Mudycrafter-rubbish-coder/fpv/docs/img/README.md

# Documentation images

| File | Contents |
|---|---|
| `kepler-v-current.png` | Current Fusion assembly |
| `fc-vtx-wiring.png` | FC, VTX, camera, and auxiliary-board wiring |
| `z-stack.gif` | Original stack-height illustration |
| `fc-mount.png` | Flight-controller mounting detail |
| `screw-map.png` | Hardware map |
| `prop-compare.gif` | 3016-3 and 3020-3 comparison |

The earlier Fusion renders are in [`../previous-versions/images`](../previous-versions/images/).

The simulation figures are not stored here. Look in [`outputs/previous-versions`](../../outputs/previous-versions/).
