Mudycrafter-rubbish-coder/fpv/outputs/cad/README.md

# CAD files

## Current print set

All dimensions are in millimeters. The STL files are exported with the print face at `z = 0`.

| File | Size | Quantity | Notes |
|---|---|---:|---|
| [`v5-base-print.stl`](v5-base-print.stl) | 117.44 x 117.44 x 4.8 | 1 | Lower frame and VTX tray mounting points |
| [`v5-top-print.stl`](v5-top-print.stl) | 52 x 48 x 3.0 | 1 | Upper plate |
| [`v5-top-layer-spacer-4.5.stl`](v5-top-layer-spacer-4.5.stl) | 42 x 41 x 4.5 | 1 | Raises the upper plate and leaves room for camera uptilt |
| [`motor-spacer-3mm-four-hole-slot.stl`](motor-spacer-3mm-four-hole-slot.stl) | 18 x 18 x 3.0 | 4 | Four mounting holes and one side wire slot |
| [`v5-vtx-tray-separate.stl`](v5-vtx-tray-separate.stl) | 28.0 x 29.2 x 15.2 | 1 | Removable VTX and fan carrier |
| [`xt30-cable-clamp-base.stl`](xt30-cable-clamp-base.stl) | 20 x 12.5 x 5.2 | 1 | Fixed C body with two 3.9 mm hex nut pockets |
| [`xt30-cable-clamp-plate.stl`](xt30-cable-clamp-plate.stl) | 20 x 2 x 3.8 | 1 | Removable pressure plate |

The motor hole pattern is a 6.364 mm square with a 9.000 mm diagonal. The upper-plate support holes are at `x,y = +/-17.5 mm`. The camera holes in the lower frame are 20 mm apart.

## Archive

Older V2, V3, and V4 parts are in [`previous-versions`](previous-versions/).

Keep those files with the old revision notes. Several dimensions changed after those models were exported, including the motor pattern, camera spacing, VTX mount, and upper-plate height.
