Mudycrafter-rubbish-coder/fpv/assets/branding/README.md

# Kepler V 品牌资源

| 文件 | 说明 |
|---|---|
| `kepler-v-boot-logo.png` | Kepler V 开机 Logo 源图；288 × 72，绿色背景，用户提供 |

这是源资源，不是生成结果。需要飞控可用的 BMP 时，使用
`tools/osd_boot_logo.py` 转换到 `outputs/osd_logo/`，不要手工改 BMP 头。

当前输出：

- `outputs/osd_logo/kepler_v_boot_logo.bmp`
- `outputs/osd_logo/kepler_v_boot_logo_preview.png`

整机名称统一写 **Kepler V**。文件名中的 `v3` / `v3r` 属于 CAD 修订号，不是飞机名。
