Mudycrafter-rubbish-coder/fpv/docs/03-机架设计.md

# 03 · 机架设计

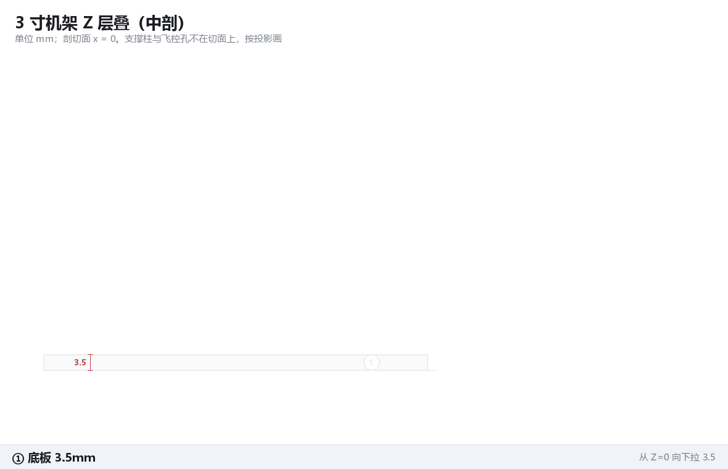
[picture p7: docs/img/z-stack.gif]
Z 层叠剖视


## 坐标系

**原点 = 机架中心，单位 mm，X = 左右，Y = 前后（+Y 朝机头），Z = 向上**

⚠️ 注意：**当前 Fusion 模型里底板占据 z = −4.0…0**。V5 增加 4.5 mm
`TOP_LAYER_SPACER` 后，上层板位于 z = 26.51…29.51；z = 0 仍是底板顶面。

> **2026-10 补充**：早期 DXF 底板厚 3.5 mm；当前做振动/冲击分析和准备打印的 STL 底板是 **4.0 mm**，上层板 3.0 mm。以 `outputs/cad/` 和 Fusion 里的实际模型为准。

## 尺寸表（v3）

| 项目 | 数值 |
|---|---|
| 电机中心 | (±47.73, ±47.73) |
| 轴距 | 135 mm |
| 相邻电机中心距 | 95.46 mm |
| 电机孔 | **孔心正方形，边长 6.364 mm，对角 9.000 mm**；4×M2 → Ø2.2 圆通孔（V5 定稿） |
| 电机座 | Ø20 圆盘 |
| 电机垫块 | **每电机 4 个独立圆小柱**（高 3 mm，**正方形孔心、9 mm 对角孔距**），整套相对机臂**顺时针 45°** |
| 中心板 | 八边形，对边 44 mm（±22），四角按 \|x\|+\|y\| = 40 切角 |
| 中心镂空 | **菱形，标称半对角 18 mm**（轴向理论宽度 36 mm，V5 扩大） |
| 机臂 | 宽 14 mm |
| 飞控孔 | **旋转 45°**：(±18.03, 0)、(0, ±18.03)，Ø2.2 |
| 支撑柱孔 | (±17.5, ±17.5)，Ø2.2（配 Ø6 柱，实购 4mm 六角黄铜也行） |
| 上下板净空 | **26.5 mm**（22 mm 支撑柱 + 4.5 mm spacer；上层板厚 3） |
| 上层板外廓 | 最大半宽 26 mm，y = −26…22 |
| 电池扎带槽 | 4 × 3.4×11 mm，位于 (±19, ±12) |
| GPS 卡槽 | 12.8 × 16.8 mm，深 2.0，R1.5，后侧 8 mm 出线缺口，中心 y=−32（V4 不装 GPS，改图传） |
| 相机扎带孔 | 4 × Ø2.6，位于 (±6.5, 22) 与 (±6.5, 30) |
| 相机托架 | V4 宽 24 mm，19 mm 双螺丝长条孔，最高 15.5 |
| 底板前端相机孔 | 两排 **x=±10.0 mm**（左右中心距 **20 mm**），y=22 / 30 |
| 独立 VTX 托架 | 28.0 × 29.2 × 13.9 mm；上下框 + 4 立柱，四颗 M2 固定 |
| 板厚 | 底板 **4.0**，上层板 3.0（早期 DXF 底板 3.5） |

## 螺丝长度怎么来的

规则：**长度 = 穿过的板厚 + 2.5mm 咬合**。完整分配表见 [01-零件规格](01-零件规格.md) 的"五金"一节，
孔位对应见下面的 `screw-map`。

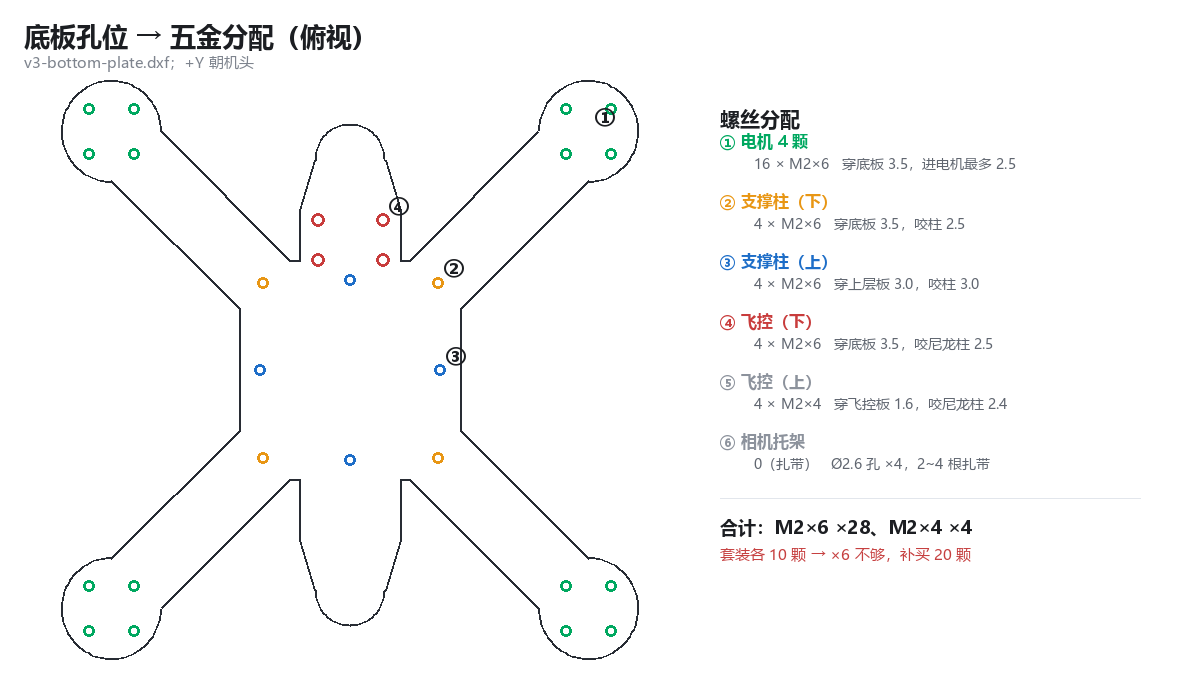
[picture p8: docs/img/screw-map.png]
底板孔位与五金分配


关键几条：

- **V4 电机用 M2×10 + 0.5 平垫**：底板 4.0 + 垫块 3.0 + 进电机 2.5；没有垫块时不要用 M2×10
- **支撑柱两端各 4 颗 M2×6**：下 4.0+2.0、上 3.0+3.0
- **飞控**：下面 4 颗 M2×6 拧进 5mm 尼龙母母柱，上面 4 颗 M2×4 穿过飞控板压住

## 两处关键的间隙校核

**桨盘余量**：底板与上层板的外沿距离任何电机中心都 **≥ 40.10 mm**，而桨的扫掠半径是 38.1 mm → 留 2 mm。
（脚本每次生成都会自动校验，改动外形后如果这个数掉到 38.1 以下会报警。）

**相机间隙**：相机托架斜面最高处 z=8.66，S1039 当前 22° 静态包络最高处约
z=20.49；增加 4.5 mm spacer 后，上层板底面在 z=26.51，静态余量约 **6.0 mm**，
为 uptilt 留出更多空间。

## 图纸状态与待确认项

> **2026-10-19 更新**：Fusion 整机装配已改用修订版托架
> `outputs/cad/previous-versions/v3/v3r-camera-tray.stl`（去掉挡镜头的前唇、加侧颊和飞控尼龙柱避让口）。
> 旧 `v3-camera-tray.stl` 只作历史对照，**不要再用它打印**。详见
> [11 · Fusion 整机装配模型](11-Fusion整机装配模型.md)。

1. **相机托架已解决**：旧 `outputs/cad/previous-versions/v3/v3-camera-tray.stl` 有挡镜头前唇和 Z 偏置问题，
   只保留作历史对照。后续版本使用 `outputs/cad/previous-versions/v3/v3r-camera-tray.stl`：已按打印坐标导出，
   底面 `z=0`，水密，并避开 S1039 镜头和飞控前侧尼龙柱。详见
   [11 · Fusion 整机装配模型](11-Fusion整机装配模型.md)。
2. **上层板也有一组飞控孔**（Ø2.2 ×4），但飞控是装在底板上的，这 4 个孔目前没有用途 ——
   要么留着当"飞控吊装在上层板下"的备选方案，要么删掉，别两边都留着又都不知道为什么。

## 版本演进

| 版本 | 内容 | 文件 |
|---|---|---|
| v1 | 单层底板，纯 2D 概念 | `outputs/cad/archive/3in-frame-1to1.dxf` / `.svg` / `-preview.png` |
| v2 | 双层结构、长中舱、机鼻机尾、相机托架 | `outputs/cad/archive/v2-bottom-plate.dxf`、`v2-top-plate.dxf`、`v2-camera-tray.dxf` / `.stl` |
| **v3** | **34→44 中心板、飞控转 45°、GPS 卡槽、托架前移 8 mm；历史基线** | `outputs/cad/previous-versions/v3/` |

v2 已作废的原因：飞控改成 45° 摆放后，安装孔落在坐标轴上，原中心板（±17）没有材料承载，必须扩到八边形 ±22。

## 图纸与图层

最新图纸在 `outputs/cad/`：

- `v3-bottom-plate.dxf` — 旧底板
- `v3-top-plate.dxf` — 旧上层板
- `v4-camera-tray.stl` — 当前相机托架（24 mm 宽，19 mm 双螺丝长条孔）
- `v3-camera-tray.stl` — 旧相机托架（前唇挡镜头，只作历史对照）
- `v3-preview.png` — 俯视预览（含前方箭头）

**要切的图层：**

| 图层 | 内容 |
|---|---|
| `CUT` | 外形 |
| `MOTOR_M2_9x9` | 16 个 Ø2.2 电机孔 |
| `FC_M2_25.5_ROT45` | 4 个 Ø2.2 飞控孔 |
| `STANDOFF_M2` | 4 个 Ø2.2 支撑柱孔 |
| `CAM_TIE` | 4 个 Ø2.6 扎带孔 |
| `GPS_POCKET` | GPS 卡槽轮廓 + 出线缺口 |
| `POCKET_OPT_1.5DEEP` | 可选：飞控底部元件避让凹槽（45° 菱形，深 1.5）——用 5mm 尼龙柱垫高后**可以不用切** |
| `BAT_STRAP` | 电池扎带槽（仅上层板） |

**只看不切（拉伸前删掉）：** `REF_PROP_3IN`（桨盘 Ø76.2）、`REF_MOTOR_CENTER`、`REF_BOARD_30_ROT45`（飞控板菱形轮廓）。

## Fusion 里的装配步骤

1. 导入 DXF（单位 mm、比例 1），草图落在 XY 平面、原点对齐
2. 底板：从 Z=0 **向下**拉 4.0 mm（对应模型的 −4.0…0）
3. 上层板：草图抬到 **Z=22**，向上拉 3 mm
4. 相机托架：旧版见 `previous-versions/v4/v4-camera-tray.stl`
5. 支撑柱：4 根 Ø6×22（实购 22mm），中心 (±17.5, ±17.5)

**自检**：导入后量三个数 —— 相邻电机孔中心距 **95.46**、飞控四孔 **25.5×25.5**、中心板 **44×44**（对边）。对得上说明没被缩放。

## 打印要求

**早期打印基线来自 [07 · 振动与打印材料方案](previous-versions/07-振动与打印材料方案.md)：PLA 4.0 mm 机臂。**
PLA 脆、耐热差，但现有厚度、螺丝长度、整机模态和冲击分析都是按它校核的；如果改用 PETG，
不要只替换材料，必须按实际厚度重新核对电机螺丝进入量、支撑柱和整机模态。

**必须平躺打印。** 让机臂的抗弯落在 XY 平面内 —— 竖着打的话一撞就从层间劈开，这是打印机架最常见的死法。

**填充**：5 圈壁、5–6 层顶/底实心层、60–80% gyroid；**机臂根部和电机座周围单独拉到 100%**。

**螺丝孔**：PLA 不要自攻（拆两次就滑牙），走 Ø2.2 通孔 + M2 螺母/铜柱。沉台不要再挖了 —— 挖薄后只允许 M2×4，反而更麻烦。

**"防炸"的本质是牺牲式连接**：撞机时让电机先被撕掉，而不是把底板撕开。所以电机座边距留到 2 mm 以上（PAD_R=10 而不是 9），相机和 GPS 全部软固定。

## 生成脚本

`work/` 下的脚本，所有尺寸都在文件开头，改完重跑即可：

| 脚本 | 作用 |
|---|---|
| `make_frame_v3.py` | 底板 + 上层板 + 预览图；`FC_ROT_45` 一行切换飞控朝向 |
| `make_tray.py` | 相机托架 STL |
| `check_frame.py` | DXF 结构审计 + 轮廓闭合性校验 |
| `inspect_dxf.py` | 列出 DXF 里所有实体（核对别人的图很有用） |
| `make_doc_assets.py` | 生成文档用的示意图和 GIF（`docs/img/`） |

运行环境：项目根目录的 `.venv`（含 ezdxf / trimesh / shapely / pillow）。
