Mudycrafter-rubbish-coder/fpv/docs/05-采购与预算.md

# 05 · 采购与预算

> **状态：已采购（2026-10）。** 下面第一份是最终实配清单，第二份是当初按"能不能飞"分批的预算方案
> （留着看省钱思路，价格是 2026-09 的估算）。
> 表格按最终方案整理，**具体品牌和数量以订单为准**。

## 一、最终实配清单

| 类别 | 项目 | 规格要点 | 数量 |
|---|---|---|---|
| 遥控 | ELRS 遥控器 | 2.4G，与板载 ELRS 匹配 | 1 |
| 动力 | 电机 | **1106 4200KV** | 4 |
| | 桨（主力） | Gemfan **3020-3**，**1.5mm 中心孔** | 8 |
| | 桨（长续航） | Gemfan **3016-3**，**1.5mm 中心孔** | 4 |
| | 电池 | 3S 650mAh ≥45C（基准）／ 3S 850mAh 70C（长续航） | 各 1 |
| | 充电器 | B3（已有）+ 电压表 + 防爆袋 | — |
| 控制 | 飞控 | JHEMCU GHF435AIO V2 | 1 |
| 视频 | 图传 | EWRF TS5823 Pro 600mW | 1 |
| | 摄像头 | S1039 1200TVL | 1 |
| | 眼镜 | DMKR 008D Pro | 1 |
| 导航 | GPS | UPRiiGNSS PU-122Q | 1 |
| 五金 | 见下表 | | — |
| | 蜂鸣器 | 5V 有源 | 1 |

### 五金明细

| 项目 | 规格 | 数量 | 说明 |
|---|---|---|---|
| M2 螺丝套装 | ×4 / ×6 / ×8 / ×10 / ×12 / ×14 / ×16 / ×18 / ×20 **各 10 颗** + M2 螺母 ×20 | 1 套 | 便宜且够用，剩下的留给以后改装 |
| M2×6 补货 | M2×6 | **+20 颗** | 整机要 28 颗，套装只给 10 颗 |
| 支撑柱 | **M2 母母 22mm**（黄铜 4mm 六角 / Ø6 都行） | 4 | 22mm 净空由它决定，**不是 25mm** |
| 尼龙柱 | M2 母母 **5mm** | 4 | 飞控垫高，避开板底元件 |
| 平垫 | Ø2.2 ×0.3~0.5 | 若干 | 电机那 16 颗用来压进入量 |
| 接头 | XT30 公母 | 1~2 对 | 做飞控电池引出线；B3 走平衡头，不需要 |
| 电容 | 470µF 低阻（≥220µF） | 1（+1 备用） | 并电池焊盘 |
| 线材 | **18AWG** 硅胶线 | 红黑各 ~0.5m | 满油 34A，20AWG 太细 |
| 其他 | 热缩管、2.5mm 扎带、**电池扎带（10mm 魔术贴）**、**RP-SMA 弯头/延长线** | | 后两样是旧清单漏的 |
| 保护件 | SS14 肖特基 ×2、2N7002 ×2、1kΩ 电阻 ×2 | | 防反接 + 录像模块触发 |

### 螺丝都拧在哪

底板孔位与五金分配

| 位置 | 长度 | 数量 |
|---|---|---|
| 4 个电机 | M2×6 | 16 |
| 支撑柱 ↔ 底板 | M2×6 | 4 |
| 支撑柱 ↔ 上层板 | M2×6 | 4 |
| 飞控 ↔ 尼龙柱（下） | M2×6 | 4 |
| 飞控 ↔ 尼龙柱（上） | M2×4 | 4 |
| 相机托架 | 扎带 | 0 螺丝 |
| **合计** | **M2×6 ×28、M2×4 ×4** | 32 |

装配层次和相机/电池/净空的关系：

Z 层叠剖视

## 二、分批预算方案（2026-09 存档）

预算 ¥1200，当时按"能不能飞"排序买了三批。实际下单时五金按上表改了，价格也随行情浮动。

| 批次 | 内容 | 估价 |
|---|---|---|
| 第一批"能飞起来" | 遥控（二手）+ 飞控 + 电机 + 图传 + 摄像头 + 桨 + 电池 + 手机接收棒 ROTG01 + 充电 + 五金 | ≈¥1115 |
| 第二批"能看到画面" | 眼镜 DMKR 008D Pro + GPS + 第二块电池 | ≈¥380 |
| 第三批"省心的" | 备用桨 + SS14 + 2N7002 + 备用天线 + TPU/泡棉 | ≈¥85 |

### 省钱的三条路

**用手机当屏幕**：EWRF ROTG01 那种 USB OTG 的 5.8G 接收棒约 ¥80，插手机上看画面，替掉眼镜。
缺点是屏幕在手上，飞行体验不如眼镜，但起步完全够。

**遥控器买二手**：ELRS 遥控器二手很常见，这东西不像电机，摔不坏。

**先目视飞**：第一批只买"能飞"的最小集，先不带图传飞。听起来像退步，其实一开始目视飞最好：
能听电机声音判断震动、能直接看姿态、调好 PID 再上图传，摔了也知道怎么摔的。

## 买东西时容易买错的五样

| 项目 | 坑 |
|---|---|
| 桨 | **3020-3 / 3016-3 都有 1.5mm 和 2mm 两种中心孔**，电机是 1.5mm 轴 |
| 电机螺丝 | 只能用 **M2×6**：M2×4 咬 0.5mm 会滑牙，M2×7 顶到线圈烧电调 |
| 支撑柱长度 | 是 **22mm**，不是 25mm（25 会把上层板顶高 3mm，图纸全对不上） |
| 电池 | 看放电倍率不看容量：45C 450mAh 只有 20A，不够；而且 XT30 连续只到 ~30A |
| B3 充电器 | 有 220V 直插版和 12V 输入版，买错还得配电源 |

## 拆机电机验货清单

1. 手拨一下，听有没有沙沙的轴承声
2. 捏住轴承位置轴向/径向晃，**有旷量直接放弃**
3. 看线材绝缘有没有破皮、焊点有没有发黑过热
4. 万用表量三相电阻，三个值应基本一致
5. 铁螺丝靠近定子，四颗吸力应相近（弱的那颗可能退过磁）
6. **四颗必须同型号同 KV**
