Mudycrafter-rubbish-coder/fpv/outputs/previous-versions/README.md

# Previous outputs

This directory holds files from earlier revisions.

| Folder | Contents |
|---|---|
| [`v2/`](../cad/previous-versions/v2/) | Earliest 3-inch frame and camera-tray files |
| [`v3/`](../cad/previous-versions/v3/) | V3 frame drawings, old camera trays, and antenna mount |
| [`v4/`](../cad/previous-versions/v4/) | V4 measured-fit parts |
| [`vibration/`](vibration/) | Arm vibration and material study |
| [`assembly/`](assembly/) | Full-assembly modal results |
| [`impact/`](impact/) | Screw pullout, arm impact, and slot tests |
| [`sim-v1-manual/`](sim-v1-manual/) | First manual simulation pass |

These files are useful for understanding how the design changed. Use the current STL set in [`../cad`](../cad/) for a new build.
