Mudycrafter-rubbish-coder/fpv/docs/img/prop-compare.png

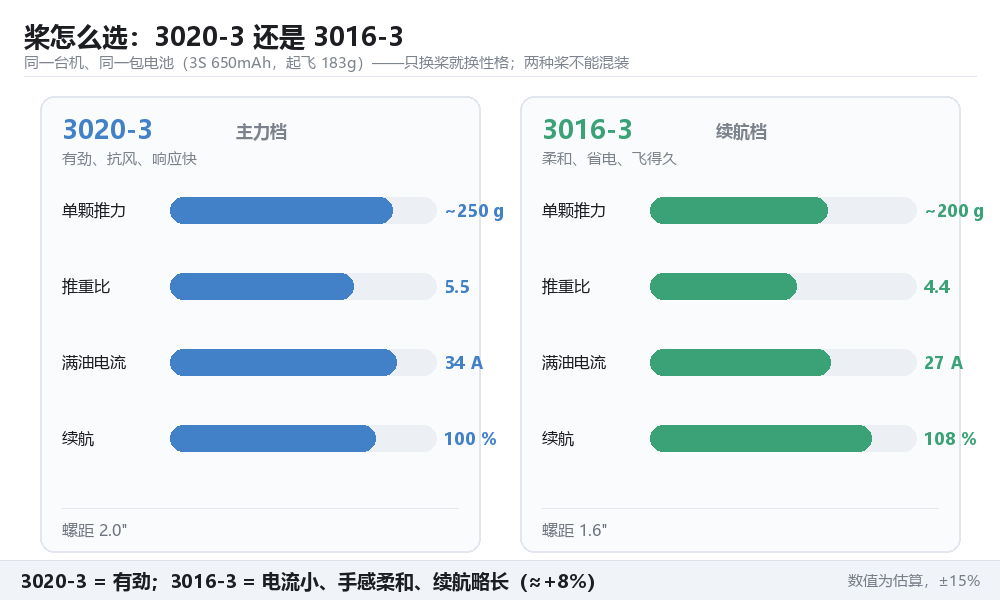
docs/img/prop-compare.png
