Mudycrafter-rubbish-coder/fpv/docs/img/z-stack.png

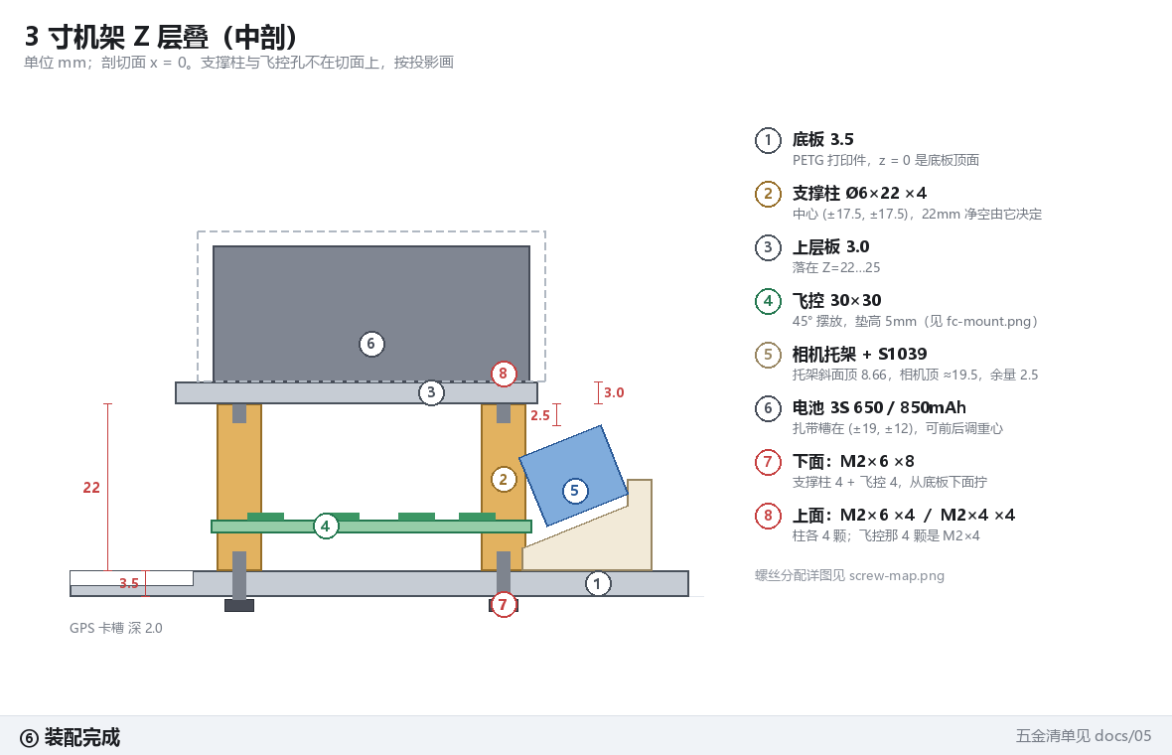
docs/img/z-stack.png
