Mudycrafter-rubbish-coder/fpv/outputs/cad/v3-preview.png

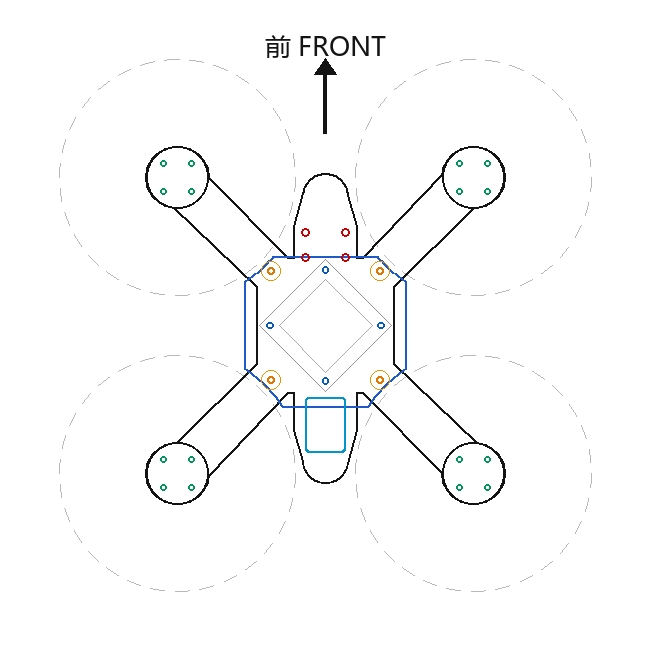
outputs/cad/v3-preview.png
