Mudycrafter-rubbish-coder/fpv/outputs/impact/stack_hole/pull_100N_stress_map.png

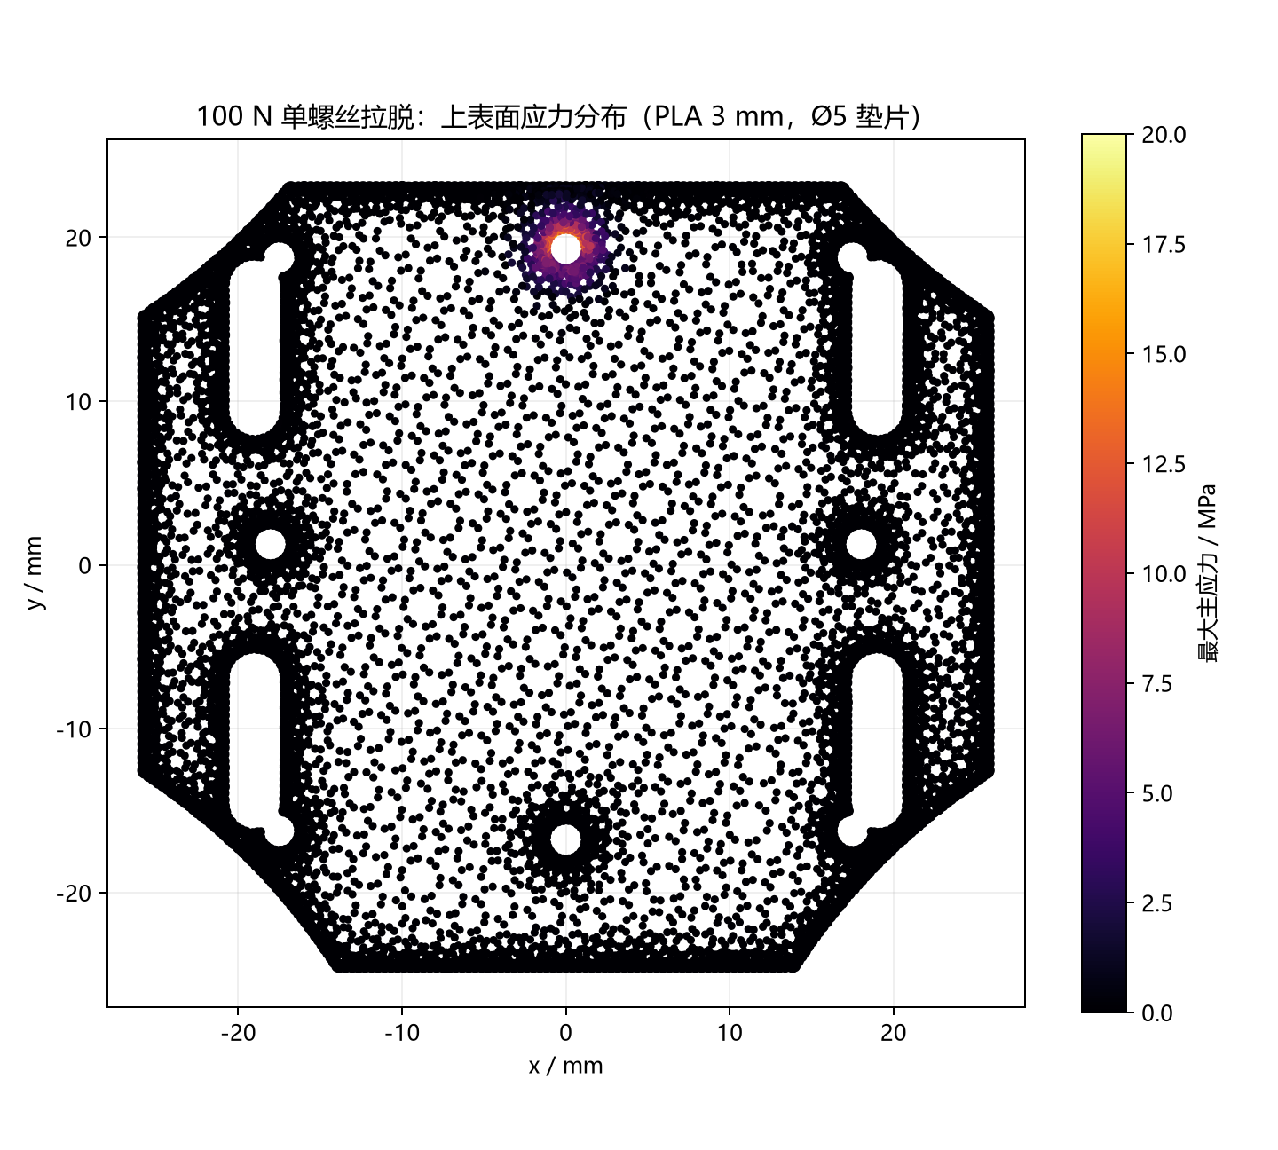
outputs/impact/stack_hole/pull_100N_stress_map.png
