Mudycrafter-rubbish-coder/fpv/outputs/osd_font/blank_11x17.png

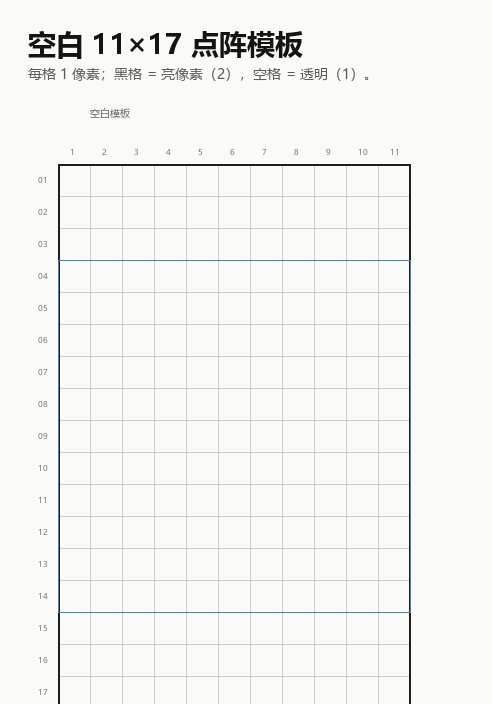
outputs/osd_font/blank_11x17.png
