Mudycrafter-rubbish-coder/fpv/outputs/osd_font/dotmatrix_page_02.png

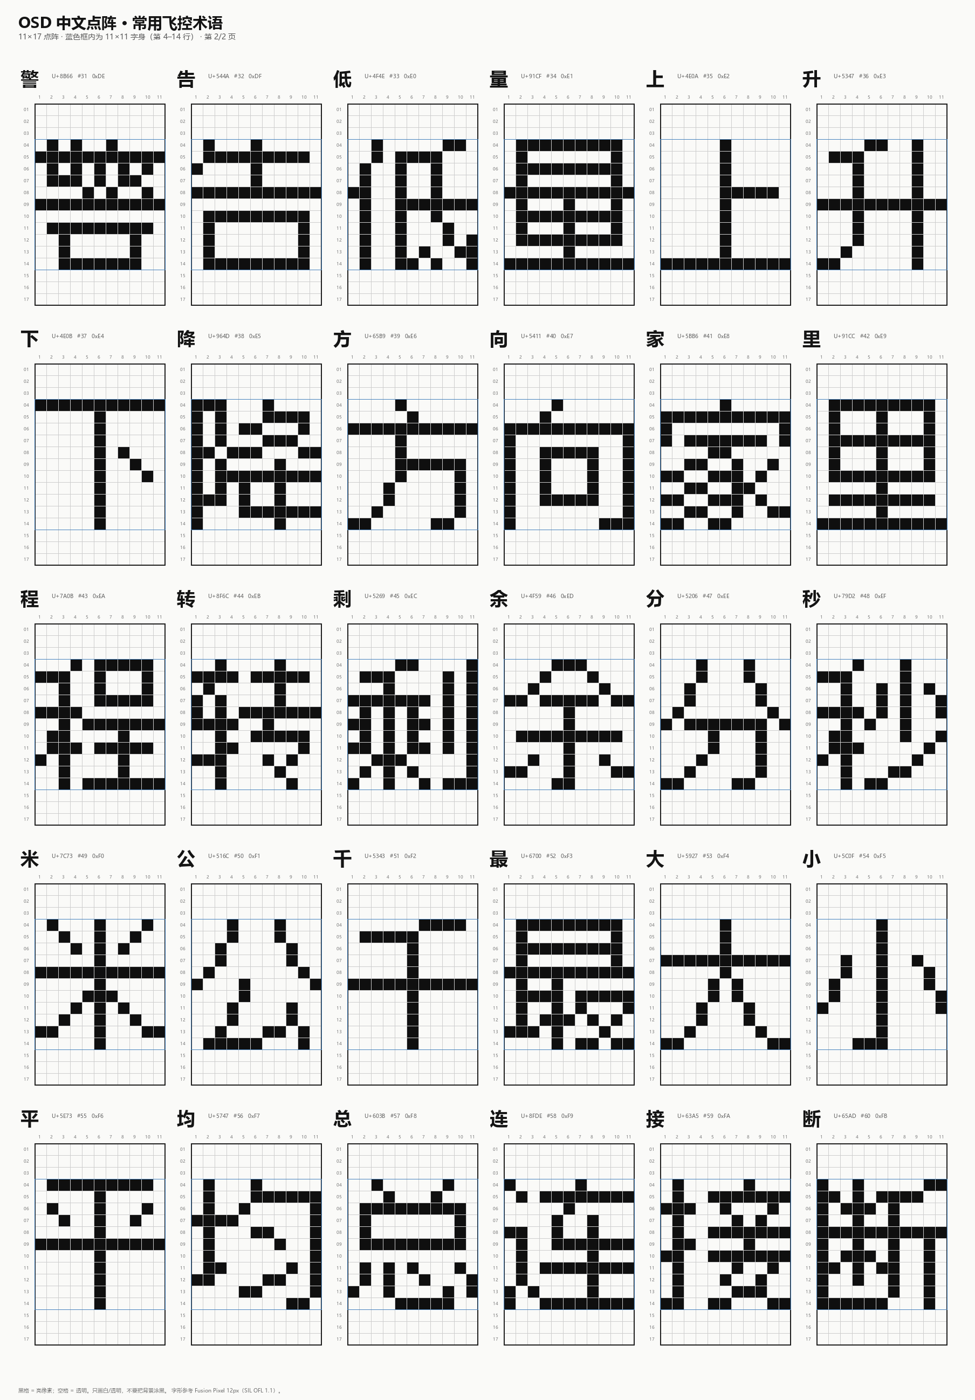
outputs/osd_font/dotmatrix_page_02.png
