Mudycrafter-rubbish-coder/fpv/outputs/osd_font/preview_osd.png

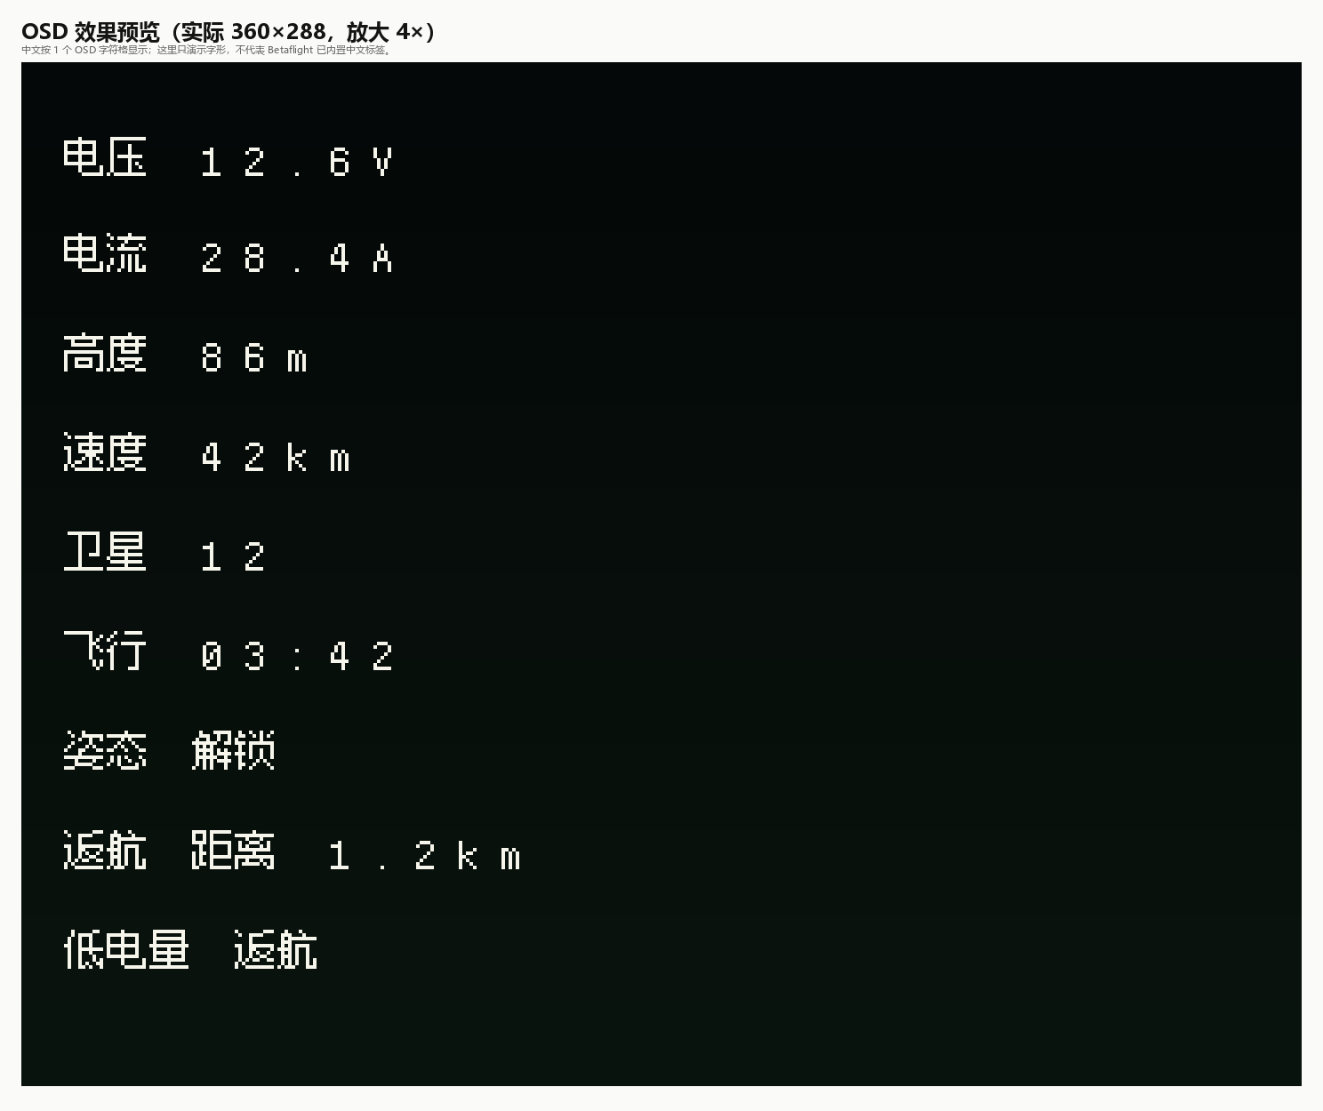
outputs/osd_font/preview_osd.png
