Mudycrafter-rubbish-coder/fpv/outputs/osd_font/rare_chars_example.png

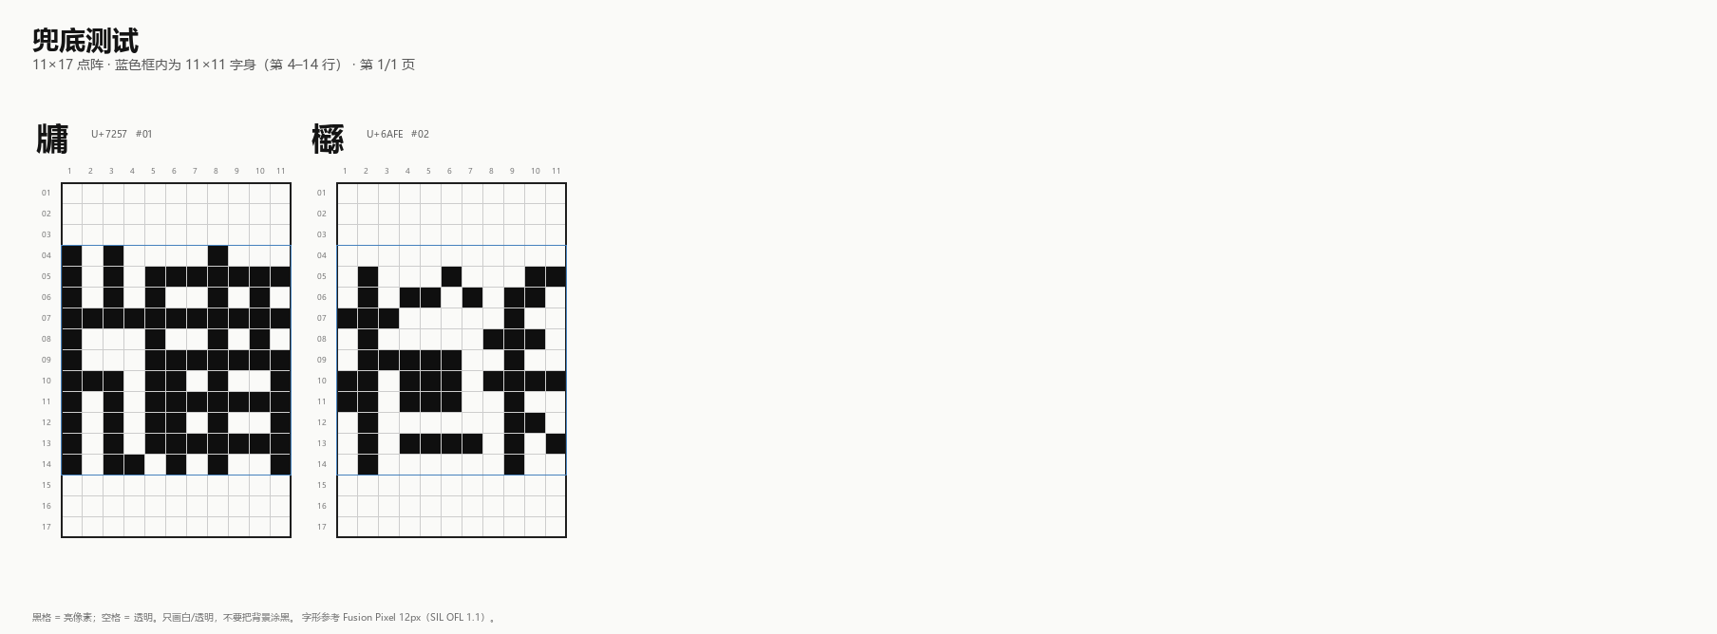
outputs/osd_font/rare_chars_example.png
