Mudycrafter-rubbish-coder/fpv/outputs/vibration/mode_shape_compare.gif

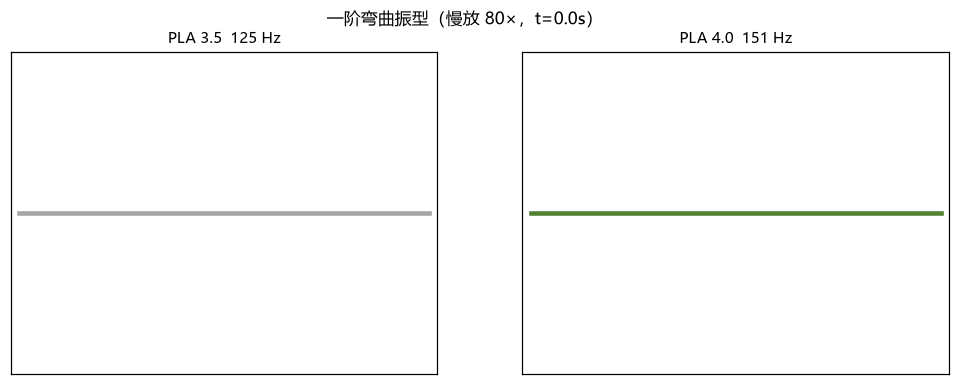
outputs/vibration/mode_shape_compare.gif
