Mudycrafter-rubbish-coder/fpv/ref/fc/jhemcu-84-0.jpg

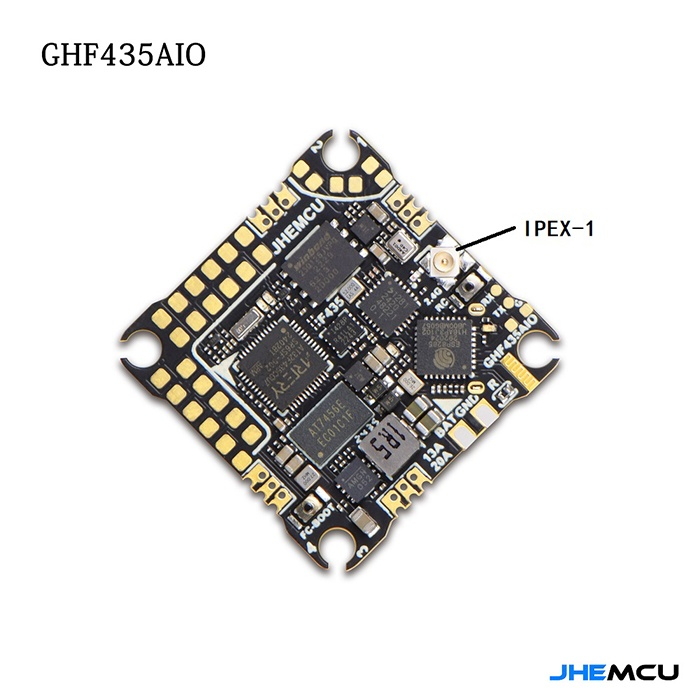
ref/fc/jhemcu-84-0.jpg
