Mudycrafter-rubbish-coder/fpv/ref/fc/jhemcu-84-1.jpg

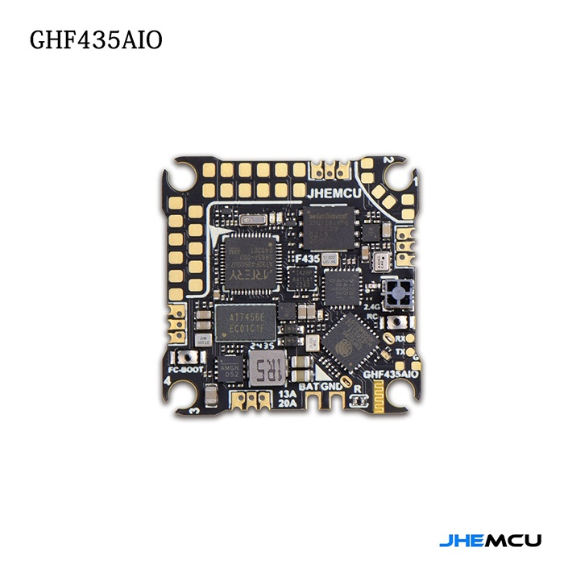
ref/fc/jhemcu-84-1.jpg
