Mudycrafter-rubbish-coder/fpv/docs/06-避坑清单.md

# 06 · 避坑清单

按"踩过的 / 差点踩的"分类，都是这个项目里真实发生过的。

## 已经付出代价的

### 1. 电源反接烧了一颗 GPS

拆机的 OV2640 录像模块和一颗 GPS，**模块上没有 LDO**，5V 反着灌进 u-blox 芯片，限流 100mA 也没救回来。

**根因**：便宜模块的电源路径常常是 `VCC → 芯片` 直连，没有任何防反接。而"限流"只能限制损失，不能防止损失。

**对策**：电源入口串一颗 **SS14/1N5819 肖特基**（压降 0.3V），一劳永逸。通电前用万用表确认极性和没有短路。

### 2. 丝印把 `AVI` 看成 `AV1`

录像模块的丝印是 **`AVI`**（视频文件格式），不是 `AV1`。一字之差，导致我们花了整整两轮讨论"这个脚到底是 AV 输出还是控制脚"。真相是：**`AVI` 和 `JPG` 是两个触发输入**，分别管录像和拍照，那个模块根本没有 AV 输出。

**教训**：读丝印时，`I`、`1`、`l`、`|` 是四个互相冒充的骗子。而且**四脚排针的丝印顺序常常和实际引脚顺序不一致** —— 判断某个脚是什么，最终要靠万用表/示波器实测，不能靠眼睛。

### 3. 电机螺丝选长了会烧电调

当前底板 4.0 mm、电机进螺丝最多 2.5 mm → **用 M2×6**，实际进入电机约 2.0 mm。

| 长度 | 露出板面 | 结果 |
|---|---|---|
| M2×4 | 0 mm | 穿不过底板 |
| **M2×6** | **2.0 mm** | ✓ 预留 0.5 mm，用这个 |
| M2×8 以上 | ≥4.0 mm | ✗ 顶到线圈，烧电调 |

**这是新手最常烧东西的地方之一**，而且烧的是电调，不是电机。打印板厚会飘，装配时逐个量进入量，接近 2.5 mm 就垫平垫。

## 设计阶段发现的（改掉了）

### 4. 电机座的圆弧被简化成直线，孔破边

你自己在 Fusion 里重画时，四个电机座的圆弧变成了直线弦。那条弦距离电机中心只有 **7.14mm**，而 9×9 孔位里对角那颗 M2 孔需要 **7.46mm** —— **破边 0.32mm**，拧螺丝时会把边缘顶裂。

### 5. 机尾/机鼻伸进桨盘

v2 的机尾两角到后电机中心只有 **37.9mm**，而桨盘半径 38.1mm —— 进圈 0.2mm。

物理上因为底板在桨平面下方 14.5mm 所以暂时打不到，**但 0.2mm 的余量是设计缺陷**：桨有公差、桨尖撞机时会甩、机尾受拉会翘。改成锥形收窄后，全机外沿距离电机中心都 ≥40.10mm（余量 2mm）。

### 6. 上层板压太低，相机会嵌进去

你为了降重心把上层板放到了 17mm。但相机托架斜面最高 z=8.66，S1039 斜放上去顶部约 19.5 —— **相机直接穿过上层板**。

**顺带纠正一个直觉**：电池只占全机质量的 1/3，上层板降 5mm 重心只降 **1.6mm**。为了这 1.6mm 牺牲相机空间完全不值。真正该在意的是**前后平衡**（电池往前放 5~7mm），不是高度。

### 7. 支撑柱会压到飞控板角

v2 时代支撑柱在 ±17、外径 Ø7，而 30×30 的飞控板角在 (15,15)，距离只有 2.83mm —— **柱子会啃进板角 0.67mm**。改成 ±17.5 + Ø6 避开。
（v3 飞控转 45° 之后这个约束其实松了很多：板边到 (17.5,17.5) 有 9.75mm，Ø6 甚至更大的柱子都安全。）

## 采购阶段踩的

### 8. 螺丝套装里 ×6 不够用

M2 套装是 ×4~×20 **各 10 颗**，看着很多，但整机光 **M2×6 就要 28 颗**（16 电机 + 8 板柱 + 4 飞控下），套装只给 10 颗。
**教训**：先用图纸把每种长度数出来再下单，别按"一包够用"想当然。补了 20 颗 ×6。

### 9. 支撑柱长度写错成 25mm

清单里原本写的是"M2 母母铜柱 25mm"，但模型和图纸都是 **22mm**（底板顶面 z=0 到上层板 Z=22，正好 22）。
买 25 会把上层板顶高 3mm，整机的 Z 全部对不上，相机余量、总高都变。**改买 22mm。**
选长度原则：**宁可长 1~2mm，绝不能短** —— 短了相机直接撞上层板（20mm 时余量只剩 0.5mm）。

### 10. 电池引出线别用 20AWG

满油峰值 34A，20AWG 在 30A 上掉 0.3~0.5V，等于白扔一截续航。**电池引出线用 18AWG。**

### 11. 850mAh 70C 的 59.5A 是吃不满的

70C × 0.85Ah = 59.5A 只是标称（廉价电池还要按 60~70% 折算成 36~42A），而**真正的瓶颈是 XT30：连续只有约 30A**。
所以别指望这包电池真能输出 60A，那得换 XT60 —— 这台机用不着，34A 峰值 XT30 扛得住。

## 还没踩但要知道的

### 12. 3D 打印机架的强度

PLA 脆、60°C 软化。**必须平躺打印**（让机臂抗弯落在 XY 平面内），竖着打一撞就从层间劈开。同价位 PETG 韧性好几倍，优先用它。

"防炸"的本质是设计**牺牲式连接**：撞机时让电机先被撕掉，而不是把底板撕开。所以电机座边距留 2mm 以上，相机/GPS 全部软固定。

### 13. B3 充电器没有存储模式

它只会一路充到 4.2V，而 LiPo 长期满电存放会鼓包掉容量。**必须配电压表，充到 3.85V/节手动拔掉**。而且它没有温控，**绝不允许无人值守充电**。

850mAh 那包在它固定的 0.8~1.2A 下要充一个多小时，充一块等一块。

### 14. 自制充电器的真正难点

如果要自己做，要知道难点不在 PWM+RC 当 DAC，而在：

- **单节独立充电需要互相隔离的三路电源** —— DIY 平衡充最经典的老大难（商用方案是"整包充电 + 平衡头泄放"）
- **ADC 精度**：MCU 内部参考 ±1~2% 换算到 4.2V 是 ±40~80mV，而 LiPo 上限窗口只有 ±0.05V → 必须外置基准 + 校准
- **失控 = 起火**：必须有**跟 MCU 无关的硬件过压切断**（TL431 比较器）、保险丝、温度开关。软件保护不算保护
- 放电用 1Ω 刹车电阻在 3S 上是 12.6A / 160W，对 650mAh 电池等于 19C 放电 —— 要用 8~10Ω/20W
- 继电器切直流触点会粘，用 MOSFET + 续流二极管，并设计成失效即断开

### 15. 老式 GPS 的坑（本项目已避开）

那颗 2011 年的 NEO-6M（17g、单星座、最高 5Hz）和现在选的 PU-122Q（4.3g、四星座、10Hz）差距是质变：

- 老模块波特率 9600，**新模块 115200，不用改**
- 老模块冷启动 30~60 秒，热启动几秒（靠备份电池）
- **15 年过去纽扣电池基本已死**，换之前每次上电都是冷启动

### 16. 图传天线必须接

600mW 图传**不接天线开机几秒就烧**。而且它的接口通常横置，需要一根 **RP-SMA 弯头或延长线**把天线竖起来，平躺着天线性能会明显掉。

### 17. 两种桨不能混装，换桨要重测返航

- 一侧 3020-3、一侧 3016-3 会抖得厉害，**四个角必须同款**
- 换桨不用重调 PID，但悬停油门会变（3020 约 43%、3016 约 48%），而 GPS Rescue 的油门判断跟悬停油门挂钩
  → **换桨后飞远之前，重跑一次失控返航测试**

### 18. 相机托架旧版有前唇和 Z 偏置（已修正）

旧 `outputs/cad/previous-versions/v3/v3-camera-tray.stl` 既有挡 S1039 镜头的前唇，也有 **3.5 mm** 的 Z 偏置，不能再用于装配。

**后续版本文件**：`outputs/cad/previous-versions/v3/v3r-camera-tray.stl`。它去掉了前唇、增加侧颊和飞控尼龙柱避让口，
按打印坐标导出，底面为 **z=0**，并已检查为水密。详见 [11](11-Fusion整机装配模型.md)。
