Mudycrafter-rubbish-coder/fpv/outputs/cad/xt30-cable-clamp-plate.stl

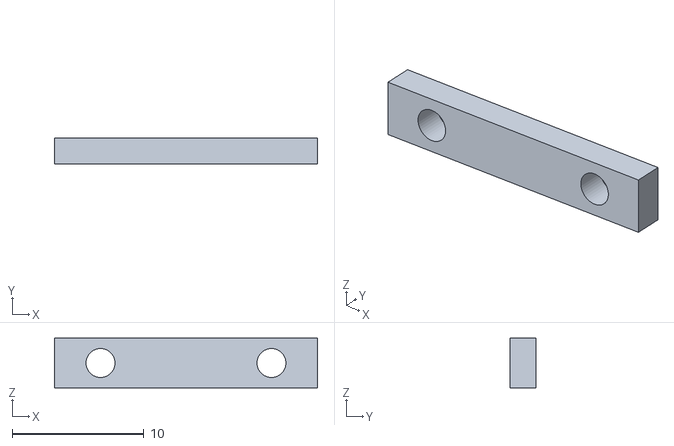
[picture p38: CAD file, 2026-10-23]
outputs/cad/xt30-cable-clamp-plate.stl
20.0 x 2.00 x 3.80
