Mudycrafter-rubbish-coder/fpv/outputs/cad/motor-spacer-3mm-four-hole-slot.stl

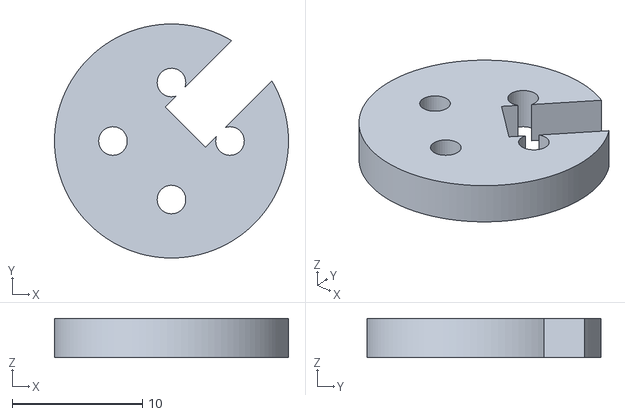
[picture p39: CAD file, 2026-10-23]
outputs/cad/motor-spacer-3mm-four-hole-slot.stl
18.0 x 18.0 x 3.00
