Mudycrafter-rubbish-coder/fpv/outputs/cad/v5-top-print.stl

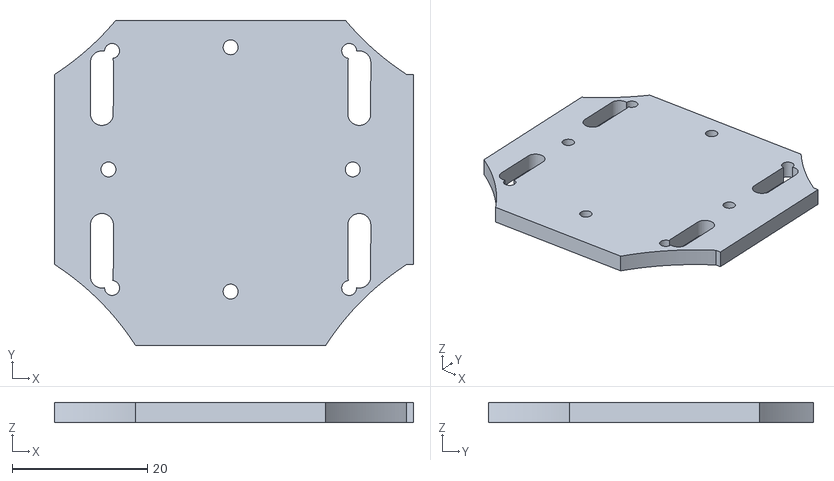
[picture p40: CAD file, 2026-10-23]
outputs/cad/v5-top-print.stl
53.0 x 48.0 x 3.00
