Mudycrafter-rubbish-coder/fpv/outputs/cad/v5-vtx-tray-separate.stl

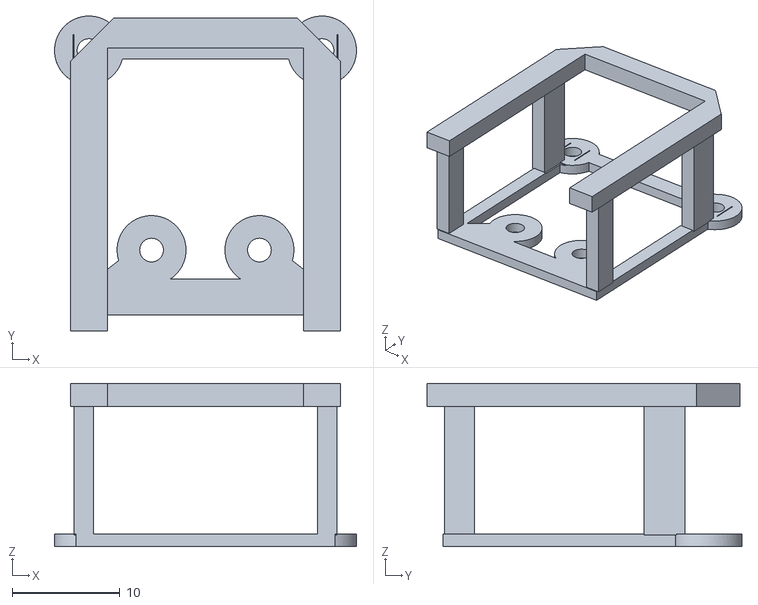
[picture p41: CAD file, 2026-10-23]
outputs/cad/v5-vtx-tray-separate.stl
28.0 x 29.2 x 15.1
