Mudycrafter-rubbish-coder/fpv/outputs/cad/xt30-cable-clamp-base.stl

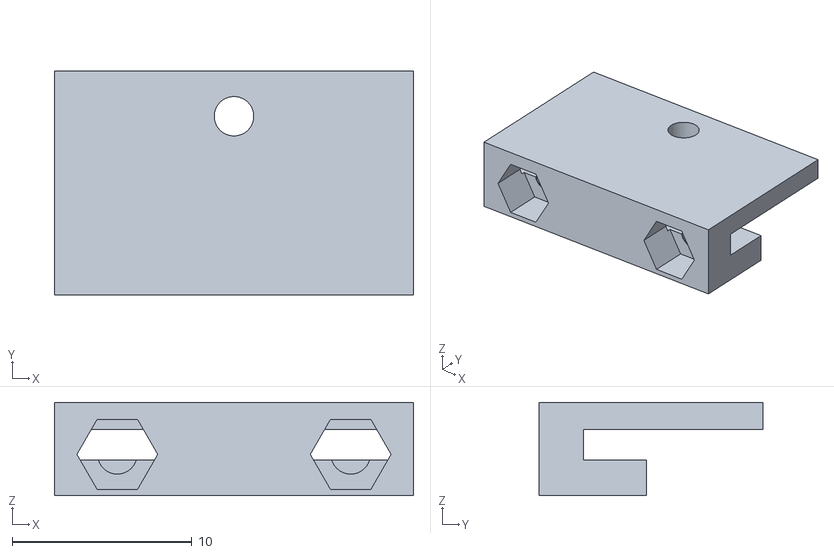
[picture p42: CAD file, 2026-10-23]
outputs/cad/xt30-cable-clamp-base.stl
20.0 x 12.5 x 5.20
