Mudycrafter-rubbish-coder/fpv/outputs/cad/v5-base-print.stl

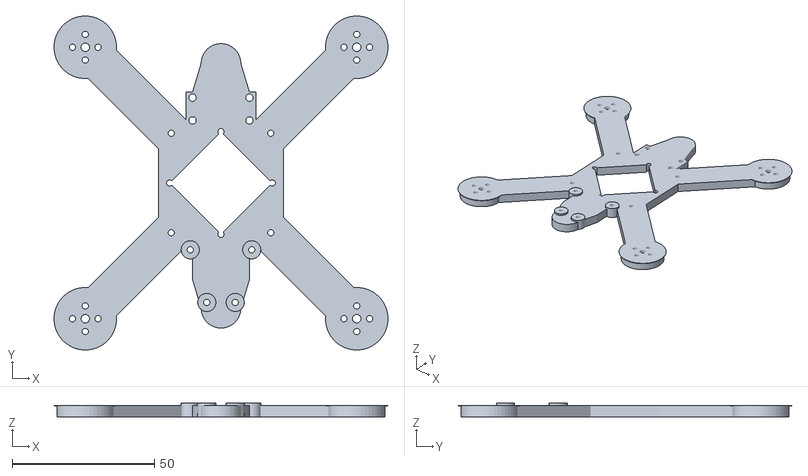
[picture p43: CAD file, 2026-10-23]
outputs/cad/v5-base-print.stl
117.4 x 117.4 x 4.80
