Mudycrafter-rubbish-coder/fpv/outputs/cad/v5-top-layer-spacer-4.5.stl

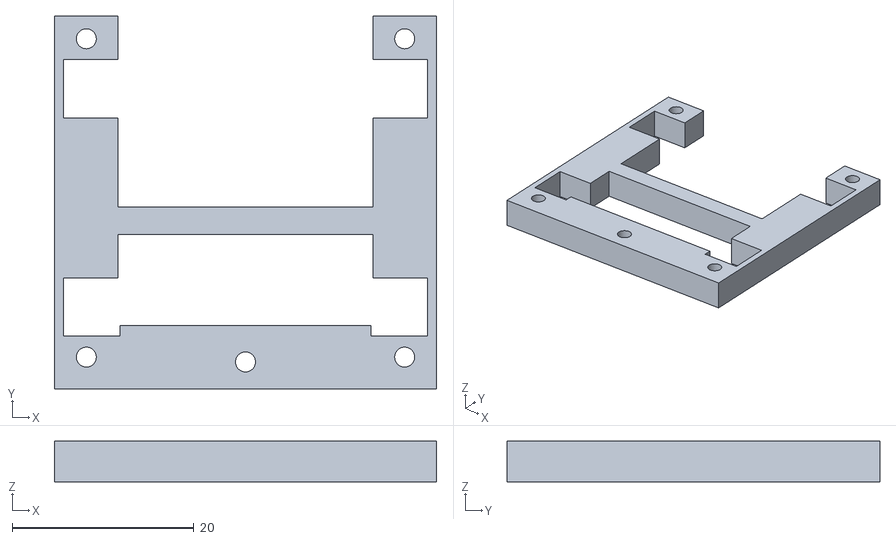
[picture p44: CAD file, 2026-10-23]
outputs/cad/v5-top-layer-spacer-4.5.stl
42.0 x 41.0 x 4.50
