Mudycrafter-rubbish-coder/fpv/outputs/cad/antenna-mount-tpu.stl

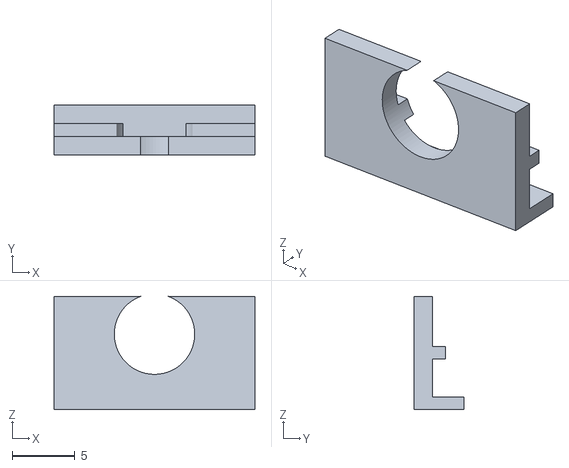
[picture p45: CAD file, 2026-10-21]
outputs/cad/antenna-mount-tpu.stl
16.0 x 4.00 x 9.00
