Mudycrafter-rubbish-coder/fpv/outputs/cad/v3r-camera-tray.stl

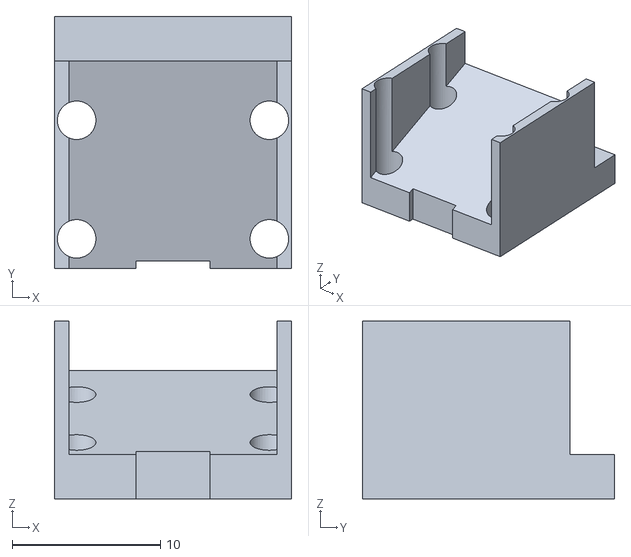
[picture p46: CAD file, 2026-10-21]
outputs/cad/v3r-camera-tray.stl
16.0 x 17.0 x 12.0
