Mudycrafter-rubbish-coder/fpv/outputs/cad/v3-bottom-plate.dxf

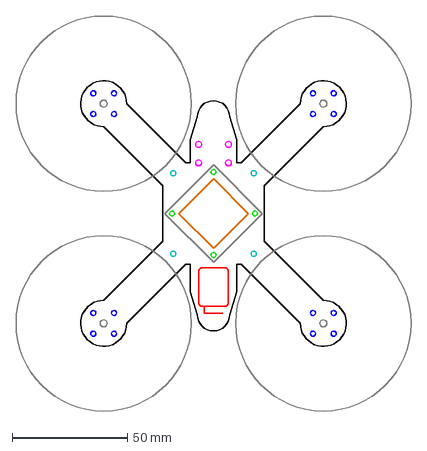
[picture p47: CAD file, 2026-10-13]
outputs/cad/v3-bottom-plate.dxf
171.7 x 171.7 mm
