Mudycrafter-rubbish-coder/fpv/outputs/cad/v3-camera-tray.stl

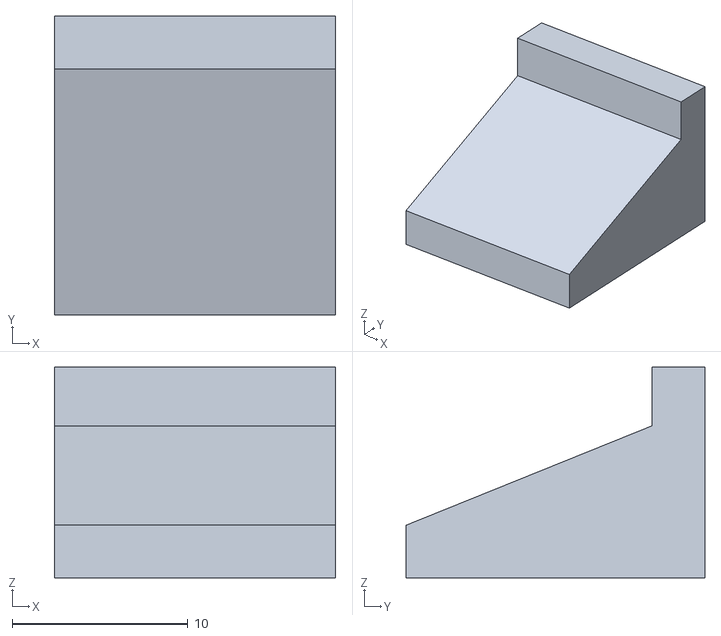
[picture p48: CAD file, 2026-10-13]
outputs/cad/v3-camera-tray.stl
16.0 x 17.0 x 12.0
