Mudycrafter-rubbish-coder/fpv/outputs/cad/v3-top-plate.dxf

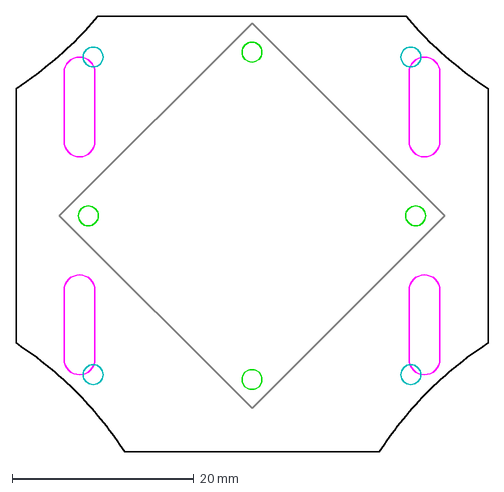
[picture p49: CAD file, 2026-10-13]
outputs/cad/v3-top-plate.dxf
52.0 x 48.0 mm
