Mudycrafter-rubbish-coder/fpv/outputs/cad/previous-versions/v2/v2-top-plate.dxf

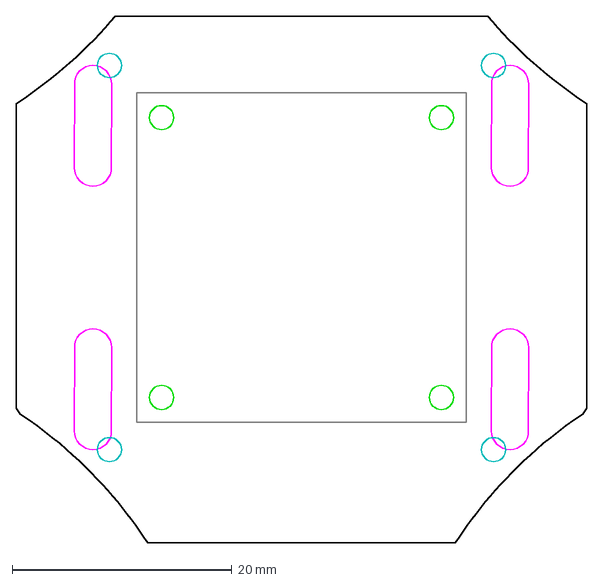
[picture p50: CAD file, 2026-10-13, an earlier design]
outputs/cad/previous-versions/v2/v2-top-plate.dxf
52.0 x 48.0 mm
