Mudycrafter-rubbish-coder/fpv/outputs/cad/previous-versions/v4/motor-riser-3mm.stl

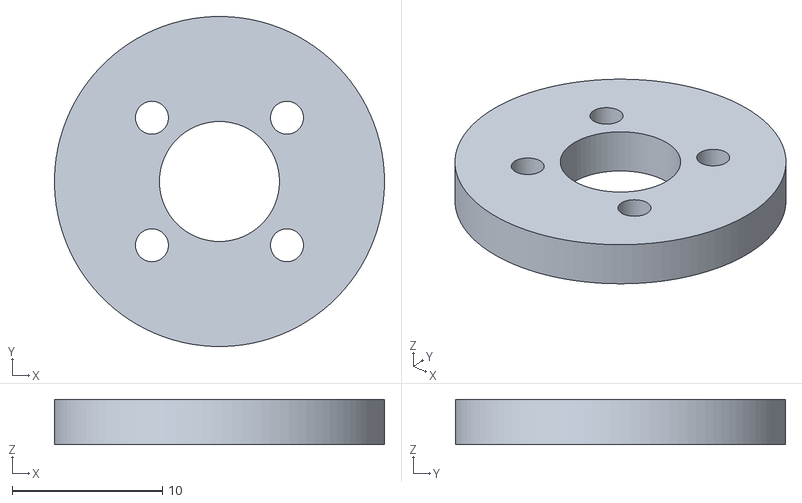
[picture p51: CAD file, 2026-10-23, an earlier design]
outputs/cad/previous-versions/v4/motor-riser-3mm.stl
22.0 x 22.0 x 3.00
