Mudycrafter-rubbish-coder/fpv/outputs/cad/previous-versions/v4/camera-bracket-19mm.stl

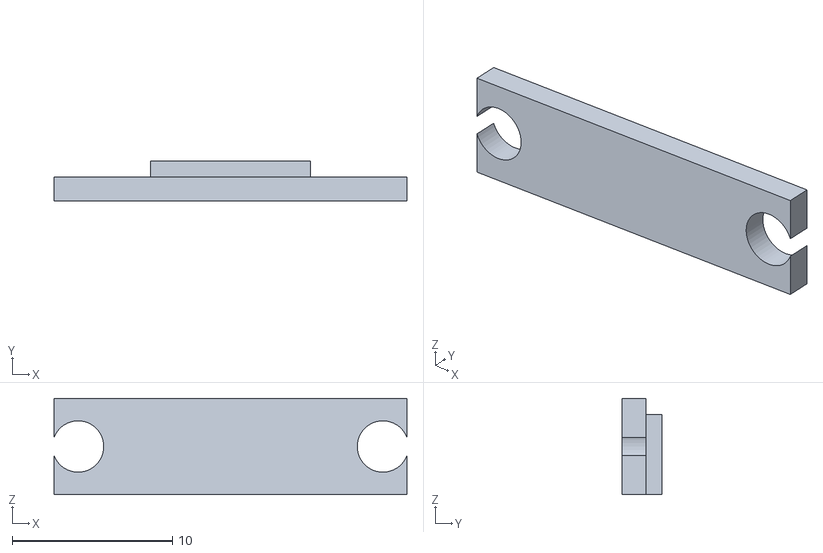
[picture p52: CAD file, 2026-10-23, an earlier design]
outputs/cad/previous-versions/v4/camera-bracket-19mm.stl
22.0 x 2.50 x 6.00
