Mudycrafter-rubbish-coder/fpv/(list of files, cad)

Other CAD files:
outputs/cad/previous-versions/v2/v2-camera-tray.stl
outputs/cad/previous-versions/v2/3in-frame-1to1.dxf
outputs/cad/previous-versions/v2/v2-bottom-plate.dxf
outputs/cad/previous-versions/v2/v2-camera-faceplate.dxf
outputs/cad/previous-versions/v2/v2-camera-tray.dxf
outputs/cad/previous-versions/v3/v3-camera-tray.dxf
outputs/cad/previous-versions/v4/v4-bottom-plate-motor9x8.5.stl
outputs/cad/previous-versions/v4/v4-camera-tray.stl
outputs/cad/previous-versions/v4/vtx-mount-19.2x25.1.stl
outputs/cad/v3-camera-tray.dxf
