Mudycrafter-rubbish-coder/fpv/outputs/previous-versions/sim-v1-manual/README.md

# 旧版手写振动仿真（已作废）

这是 2026-10-17 的第一版机臂模态结果，已被 [docs/07](../../../docs/previous-versions/07-振动与打印材料方案.md) 取代。

作废原因：

- 碳纤维被按 60 GPa 各向同性材料处理，不符合正交各向异性实际；
- 高阶模态统一套用一阶端质量修正，方法不严谨；
- 未记录完整的网格/材料/边界/验证字段。

保留仅作历史对照，不要用这里的数字做设计决定。
