Mudycrafter-rubbish-coder/fpv/(commit log)

2026-10-13 3 寸 FPV 机架：CAD 图纸、设计文档与采购方案
    - outputs/: v3 底板/上层板 DXF、相机托架 STL、预览图（archive/ 为作废版本）
    - docs/: 零件规格、动力与推重比、机架设计、接线与配置、采购与预算、避坑清单
    - ref/: 飞控接线图、GPS 规格、板卡照片等参考资料
    - fusion_mcp.md: 给 AI 用的 Fusion MCP 工程规范
    - .gitignore: 排除 work/ 与 .venv/
    [3in-frame-1to1.dxf, v2-bottom-plate.dxf, v2-camera-faceplate.dxf, v2-camera-tray.dxf, v2-camera-tray.stl, v2-top-plate.dxf, v3-bottom-plate.dxf, v3-camera-tray.dxf]
2026-10-13 文档更新：采购完成、五金实配（22mm 柱 / M2 分配）、桨与电池新方案，附示意图与动画
    README：状态改已采购、结论速查补螺丝/柱长/线径/两种桨、目录结构加 docs/img 与 ref/fc。
    01：飞控固定方式、3020+3016 两套桨、650/850mAh 电池与 XT30 限制，新增五金实配表。
    02：对比表加 3016 与 850mAh 两行、电池表加 70C；重量账重算（空机 123g、起飞 183g），推重比 6.5 → 5.5。
    03：螺丝长度推导、孔位-五金对照图、两条待核对（托架 Z 偏置、上层板飞控孔）。
    04：新增供电/电容/线径一节；电机螺丝只能用 M2×6；GPS Rescue 按两种配置提醒。
    05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
2026-10-18 振动与冲击分析：PLA 4.0 方案、stack 孔拉脱与 3D/热力图动画
    [design_matrix.csv, key_results.csv, modal_freqs.csv]
2026-10-18 长槽半孔拉脱：250g/500g 面内/面外、3D 与热力图动画
    [slot_pull_summary.csv]
2026-10-19 仓库整理：README 视觉索引、outputs 分类与文档链接修复
    [3in-frame-1to1.dxf, slot_pull_summary.csv, v2-bottom-plate.dxf, v2-camera-faceplate.dxf, v2-camera-tray.dxf, v2-camera-tray.stl, v2-top-plate.dxf, v3-bottom-plate.dxf]
2026-10-19 整机装配模态：PLA 全件、网格收敛与 3D 振型动画
    [mode_frequencies.csv]
2026-10-19 README：整机装配模态、网格收敛与悬停带结论
2026-10-21 Kepler V：整理文档并加入装配与 OSD 工具
    [BETAFLIGHT_BASE_NOTICE.txt, antenna-mount-tpu.stl, glyphs.csv, osd_cn_map.csv, v3r-camera-tray.stl]
2026-10-23 Publish current flying configuration and archive earlier designs
    [3in-frame-1to1.dxf, antenna-mount-tpu.stl, camera-bracket-19mm.stl, design_matrix.csv, key_results.csv, modal_freqs.csv, mode_frequencies.csv, motor-riser-3mm.stl]
